ok1cdj/M5-ESP32-keyer/src/settings.h

// Persistent settings in NVS.
#pragma once

#include <stdint.h>

#include <string>

#include "command.h"

namespace settings {

void begin();

proto::Mode mode();
void setMode(proto::Mode m);

uint8_t wpm();
void setWpm(uint8_t wpm);

std::string ssid();
std::string password();
void setWifi(const std::string& ssid, const std::string& password);

// Empty key = HTTP authentication off.
std::string apiKey();
void setApiKey(const std::string& key);

// Display rotation in quarter turns, 0-3.
uint8_t rotation();
void setRotation(uint8_t r);

civ::Config civConfig();
void setCivConfig(const civ::Config& cfg);
// The rig the automatic detection found last; rig 0 = none yet.
void civLast(uint8_t& rig, uint32_t& baud);
void setCivLast(uint8_t rig, uint32_t baud);

}  // namespace settings
