ok1cdj/M5-ESP32-keyer/(commit log)

2021-01-29 Config button on index.html
2026-09-28 v2: CW keyer firmware for the M5Stack Atom family
    New major version, rewritten on PlatformIO for Atom Lite, AtomS3 Lite and
    AtomS3. M5StickC support is dropped.
    - Keyer core as a pure C++ event-driven state machine (lib/keyer_core)
    with an element generator shared by future paddle input; host tests
    run with `pio test -e native`
    - Safety in the core: output opened before setup(), immediate STOP,
    5 s keying watchdog, STOP on BLE disconnect, task watchdog reset
    - One transport per boot, selected by the button at power-on:
    BLE (Nordic UART + Battery Service), HTTP (v1 /sendmorse, /cmd) and
    cwdaemon UDP, with mDNS keyer-XXXX.local in the Wi-Fi modes
    - Text protocol documented in PROTOC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
    [battery.cpp, battery.h, ble_nus.cpp, commands.cpp, commands.h, cwdaemon.cpp, device_name.cpp]
2026-09-28 CI: pin PlatformIO 6.1.19 for the S3 hybrid compile
    PlatformIO 6.2 installs SCons 4.11, where SCons.Tool.FortranCommon is
    gone and the pioarduino 55.03.39 custom_sdkconfig build fails.
2026-09-29 AtomS3: put the display panel to sleep with the backlight off
    Record the measured current of AtomS3 Lite and AtomS3 in the README.
2026-09-29 README: mode switching with the button tested
2026-09-29 Atom Lite tested; blink the LED on a button press
    - Blink the LED briefly after each debounced button press, so the press
    can be seen. On the AtomS3 it wakes the display, as before.
    - Check that an NVS key exists before reading it, so a board without
    Wi-Fi credentials no longer logs a Preferences error at boot.
    - README: Atom Lite current (~40 mA, ~50 mA sending), watchdog test
    ticked, Atom Lite listed as tested.
    [keyer_task.cpp, settings.cpp]
2026-10-04 Move the key output to the Grove port
    KEY is now on the Grove SDA pin (Atom Lite G26, AtomS3 G2), so one Grove
    cable carries everything for the radio. The SCL pin (G32 / G1) is reserved
    for a planned CI-V interface. The paddles and the battery stay on the side
    header. M5Unified only assigns the Grove pins to Ex_I2C and doesn't start
    it while external_rtc/imu are off.
    Claude-Session: https://claude.ai/code/session_01CsD4x3AxWaPEipBSNsoLAi
2026-10-05 v2.0.1: real keying through the Grove port tested
    Checked on the AtomS3 over BLE and on the Atom Lite over cwdaemon:
    keying at 20 WPM, the output stays open across power-on and a reset
    mid-message, and STOP, the button and ESC 4 open it immediately.
2026-10-05 README: keying through an optocoupler or an N-MOSFET
2026-10-05 README: N-MOSFET keying tested
2026-10-06 Battery: correct the low reading of the 1 MOhm divider on the S3 boards
    A full charge (LGS4056 ends at 4.20 V) read 4045 mV, so a charged
    battery showed about 80 %. BAT_CAL_PERMILLE=1038 on the AtomS3 builds;
    the Atom Lite keeps 1000 until it is measured the same way.
    Claude-Session: https://claude.ai/code/session_01VqsBfuGYsAPeDmbctcnoSq
    [battery.cpp]
2026-10-06 Battery: the Atom Lite reading needs no correction
    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
    [battery.cpp]
2026-10-06 v2.0.2: battery reading calibrated on the AtomS3 boards
    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
2026-10-08 v2.1.0: Icom CI-V frequency reading and a CI-V tunnel
    - lib/civ: frame parser and the link state machine (rate and rig address
    detection, probing with Transceive off, polling, rig lost), host-tested.
    - src/radio: UART1 open-drain on the Grove SCL pin, one wire, own task.
    - Commands FREQ, FREQ ON/OFF, CIV, CIVTX, CIVRX ON/OFF. Async messages are
    opt-in per BLE connection, so existing clients get no unexpected lines.
    - Frequency on the AtomS3 display and on the HTTP page.
    - README: BSS138 level shifter with the gate from a divider on the Grove 5V
    (a single diode cannot receive); PROTOCOL.md: FREQ, CIV and the tunnel.
    Not tested on hardware yet.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
2026-10-11 CI-V: fixes from the first test with an IC-706MkII
    - The pin held the bus low: gpio_set_direction() after uart_set_pin()
    reconnects the pin to the plain GPIO output. Set only the open-drain
    driver (gpio_ll_od_enable).
    - One frame on the bus at a time: wait for the rig's answer (max 100 ms)
    before the next frame, client frames before our own queries. The rig
    dropped a command sent right after another one.
    - Remember the rig found last (NVS) and ask it first after a start, so a
    rig with a changed address (this one is 4D) is found without Transceive.
    - Report the frequency only once the mode is known too (no "?" flash).
    - CIV_DEBUG build flag: per-second bus statistics on the serial p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
2026-10-11 README: CI-V display and cable-pull test passed
    Claude-Session: https://claude.ai/code/session_01F6DshncJ5kGnb8KFsooBF6
2026-10-11 Docs: v2.1.0 review (display rotation, CI-V commands per mode, tested boards)
2026-10-11 README: CI-V pin in the board table
2026-10-11 Build guide page: parts, shop links, schematics, in EN and CS
    docs/build.html (keyer.ok1cdj.com/build.html): what to buy (M5Stack shop,
    Botland), how the parts go into the cable, the Grove pins with wire colours,
    keying by optocoupler or MOSFET and the CI-V level shifter as SVG schematics,
    then the flasher and getting it going in kQSO. English and Czech (?lang=).
    Opened from kQSO (?app=kqso&display=&theme=) it takes kQSO's look. A photo
    section shows once photos are added. Linked from the flasher page and README.
    Claude-Session: https://claude.ai/code/session_015nuNHVhmKpfuc67ScKCyXd
2026-10-12 Flasher page in English and Czech
    The same switch as the build guide: EN / CS at the top, ?lang= or the
    browser's language. Every text, the select options and placeholders, and
    what the Bluetooth configuration writes (status, CI-V line, log messages)
    follow it. Links between the two pages keep the language. The intro now
    mentions CI-V.
    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
2026-10-13 BLE: binary CI-V pass-through for adapter apps (OrbitDeck)
    A connection whose first byte is FE carries raw CI-V frames both ways,
    like an OrbitLinkS3: frames go out readdressed as with CIVTX, the
    radio's frames come back unchanged, no text lines are sent.
